iatsuk/nasa-duo-clipper-to-nmea2k/docs/power.ru.md

# Потребление: расчёт, не измерение

**Полностью автономное устройство пока не спроектировано: его потребление
неизвестно.** Ниже оценка LCD-прототипа с DevKitC, буфером и MIKROE-2627.
Потребление MFD и других приборов NMEA сюда не входит.

## Принятые величины

| Узел | Рабочая оценка | Статус |
|---|---:|---|
| ESP32 DevKitC, без радио | 50–100 мА на входе 5 В | Инженерный запас, зависит от платы, USB-UART, LED и CPU |
| Изолированный CAN-модуль | 30–90 мА от 5 В в среднем | Зависит от нагрузки шины; это не гарантированный максимум |
| Буфер и вспомогательные цепи | Эквивалент 5 мА от 5 В | Расчётный запас; потребление 3,3 В уже приведено к входу 5 В |
| КПД DC/DC | 85% | Допущение в рабочей точке, проверить измерением |
| Падение на входном диоде | Около 0,35 В | При малом токе, зависит от детали и температуры |
| Сохранённый NASA | 10–100 мА от 12 В | Широкий оценочный диапазон, **не паспорт Duet** |

Паспортные токи одного ESP32 не равны току DevKitC. Ток ADM3053 зависит от
состояния CAN; пиковый ток выше среднего. Питание 5 В выбрано с запасом до 1 А.
Основные источники: [ESP32](https://documentation.espressif.com/esp32_datasheet_en.pdf),
[ADM3053](https://www.analog.com/media/en/technical-documentation/data-sheets/ADM3053.pdf),
[DC/DC](https://www.pololu.com/product/2831).

## Формула

```text
I_5V = I_ESP32 + I_CAN + I_aux
I_bridge_12V = 5 × I_5V / (efficiency × (12 - V_diode))
I_total_12V = I_bridge_12V + I_NASA_12V
P_total = 12 × I_total_12V
Ah_per_day = 24 × I_total_12V
Wh_per_day = 24 × P_total
```

Диапазон дополнительного адаптера: примерно **0,52–1,18 Вт**, или
**43–98 мА от 12 В**. Вместе с сохранённым NASA получается примерно
**0,64–2,38 Вт**, **53–198 мА от 12 В**, **1,27–4,76 А·ч в сутки**.
Практически удобно округлить предварительный бюджет всей системы до **0,7–2,4 Вт**.
Это расчётный диапазон, не гарантированные минимум/максимум.

Центральный пример: ESP32 70 мА + CAN 45 мА + 5 мА вспомогательных = 120 мА
на 5 В. С учётом преобразования и диода адаптер берёт около 61 мА на 12 В.
Если конкретный NASA берёт 20 мА, сумма около **81 мА, 0,97 Вт, 1,93 А·ч/сутки**.
При 14 В ток будет другим; сравнивать полезнее ватт-часы.

Выполнить расчёт с другими допущениями:

```sh
python3 tools/power_budget.py
python3 tools/power_budget.py --voltage 13.8 --nasa-ma 30 --esp-ma 80
```

## Как получить настоящее число

1. Измерить отдельно ток штатного NASA при подсветке выключенной и включённой.
2. Измерить адаптер на его входе 12 В, без USB-питания, с подключённой CAN-сетью
   и реальным цифровым потоком. Измерение только по USB пропустит потери DC/DC.
3. Для амперметра разорвать **плюсовой провод после предохранителя** и включить
   прибор последовательно. Нельзя ставить амперметр поперёк аккумулятора.
   Если нет опыта, удобнее готовый DC-ваттметр или лабораторный источник с индикацией.
4. Записать напряжение, средний ток за 10 минут, максимум при старте, температуру
   корпуса после часа. Повторить при активной сети и включённом двигателе.
5. Измерить весь комплект на общем входе и сверить с суммой отдельных измерений.

В `docs/validation.ru.md` есть таблица для результатов. До её заполнения цифры
выше остаются оценкой. LEN=0 касается только питания от NET-S, а не аккумулятора.

Снижать потребление можно уменьшением частоты CPU после проверки захвата SPI,
заменой DevKitC на собственный модуль и выбором более экономичной изоляции.
Deep sleep не применим: пропуская LCD-поток и CAN, устройство теряет своё назначение.
