iatsuk/nasa-duo-clipper-to-nmea2k/docs/standalone.ru.md

# Полностью новая плата с прямыми входами датчиков

Это исходная цель проекта. Текущий LCD-прототип — вспомогательный вариант,
а не выполнение этой цели. Здесь нет готовых Gerber, аналогового приёмника
или прошивки возбуждения датчика: их нельзя обоснованно подобрать без измерений.

## Что уже известно

NASA продаёт запасной глубинный преобразователь **150 кГц**. Это пьезоэлемент
с коаксиальным кабелем, не NMEA-источник. Номинальную частоту конкретного датчика
нужно сопоставить с маркировкой. Инструкция Duet описывает регулировку усиления
приёмника и эхо-посылки. [NASA, документация и каталог](sources.md).

Для глубины понадобится передатчик, согласование с пьезоэлементом, развязка
передачи/приёма, защита чувствительного приёмника, полосовой усилитель,
детектор/АЦП и обработка нескольких отражений. Формула `d = c × t / 2` —
лишь последний шаг. При c≈1500 м/с глубине 100 м соответствует около 133 мс
двойного хода; это задаёт окно ожидания и ограничивает частоту посылок.

Популярный PGA460 не является готовым выбором для 150 кГц: его штатные диапазоны
30–80 и 180–480 кГц не включают эту частоту. Это проверено по
[документации TI](https://www.ti.com/lit/ds/symlink/pga460-q1.pdf).
Модули HC-SR04/JSN-SR04T для воздуха не заменяют морской эхолот.

Лаг проще, но тип его выхода нельзя угадывать: нужен сигнал вашего датчика,
питание/подтяжка, полярность, число импульсов за оборот и калибровка. Отсутствие
импульсов само по себе не отличает неподвижную лодку, заблокированную крыльчатку
и оборванный провод. Ни LCD-прототип, ни простой счётчик не решают это различие.

## Первый пакет данных — без выпайки и измерений высокого напряжения

1. Чёткое фото лицевой стороны: точное название Duet/Dual/другой модели.
2. Фото задней стороны и обоих штекеров, маркировок датчиков, если доступны.
3. При полностью отключённом питании — фото обеих плат с двух сторон,
   читаемые обозначения микросхем и версия PCB; ничего не отсоединять силой.
4. Размеры плат, высота компонентов, расстояния крепёжных отверстий.
5. Модель будущего MFD и желаемый предельный размер коробки.

**Фото помогут определить архитектуру, но не заменят следующие измерения.**

## Что измеряет специалист по электронике

| Измерение | Для какого решения |
|---|---|
| Импеданс/ёмкость датчика вместе с кабелем, резонанс | Согласующая цепь и передатчик |
| Напряжение, длительность, частота и число циклов штатной посылки | Напряжение ключей и параметры возбуждения |
| Затухание после посылки, эхо на нескольких глубинах | Защита приёмника, blanking, усиление, фильтрация |
| Динамика/амплитуда выхода лага и число импульсов на оборот | Входной буфер, подтяжка и калибровка |
| Работа при 10–15 В, моторе, помпе и зарядке | Питание, фильтры и помехоустойчивость |

Нужны осциллограф и подходящий дифференциальный высоковольтный пробник,
ограниченный источник питания, логический анализатор для **цифровых** линий.
Обычный USB-анализатор нельзя подключать к разъёму эхолота. Земля обычного
осциллографа может быть соединена с защитным заземлением: схему измерения выбирает
специалист. У пользователя без опыта этот этап не является инструкцией для самостоятельной пайки.

## После измерений

1. Составить измеренные характеристики и требования, выбрать аналоговую часть.
2. Проверить передатчик и приёмник на отдельном стенде с ограничением энергии.
3. Написать драйвер выбранной аналоговой части и обработку эха; использовать уже
   подготовленный NMEA-выход после испытаний.
4. Сравнить показания с исходным NASA на мелкой/большой глубине, при движении,
   пропадании эха, пузырьках и нескольких отражениях. Сохранить сырые записи.
5. Выпустить KiCad-схему, пройти ERC, развести плату, пройти DRC и проверку
   цепей питания/изоляции; заказать первый экземпляр, а не серию.
6. По фактической плате выпустить корпус, проверить нагрев, конденсат и вводы.

Размер, конечная BOM и потребление полностью автономной версии до выбора
аналоговой части **не определены**. ESP32 может остаться цифровым контроллером;
если нужная оцифровка/таймеры этого потребуют, выбор MCU пересматривается.
