iatsuk/nasa-duo-clipper-to-nmea2k/docs/bom.ru.md

# Что купить для LCD-прототипа

**Сначала подтвердить модель/ревизию NASA фотографиями.** Список относится к
адаптеру с сохранением прибора. Не заказывать по нему плату автономного эхолота.

| Количество | Позиция | Требование / где искать |
|---:|---|---|
| 1 | ESP32-DevKitC V4 с ESP32-WROOM-32E, 4 МБ | ESP32 классический; USB; магазины Espressif/Mouser/DigiKey |
| 1 | [MIKROE-2627 CAN Isolator Click](https://www.mikroe.com/can-isolator-click) | ADM3053; схема v100; наличие проверить у дистрибьютора |
| 1 | [Pololu D24V10F5, #2831](https://www.pololu.com/product/2831) | Фиксированные 5 В, до 1 А; не внешне похожая версия 3,3 В |
| 1 | [SN74LVC125AD](https://www.ti.com/product/SN74LVC125A) | SOIC-14; буфер с 5-В-толерантными входами |
| 1 | Переходник SOIC14→DIP14 | Под корпус AD; можно заказать уже припаянный U1 |
| 3 | Резисторы 1 кОм, 1%, 0,125 Вт или больше | Последовательно DATA/WR/CS |
| 3 | Резисторы 1 МОм | Определённые уровни входов U1 |
| 2 | Резисторы 10 кОм | TXD pull-up и ARM pull-up |
| 2 | Конденсаторы 100 нФ, керамика | U1 и выход 5 В |
| 1 | Конденсатор 1 мкФ, ≥10 В | U1, линия 3,3 В |
| 1 | Конденсатор 100 мкФ, 50 В | Вход DC/DC |
| 1 | Конденсатор 100 мкФ, 10 В или выше | Выход DC/DC |
| 1 | SS34 + удобный переходник при необходимости | Диод Шоттки защиты полярности |
| 1 | SMBJ18A + переходник | Однонаправленный TVS |
| 1 | Держатель предохранителя + предохранитель 0,5 А | В линию 12 В рядом с отбором питания |
| 1 | Паяемая макетная плата примерно 70×50 мм | Для буфера/защиты; размеры предварительные |
| 1 | Разъём 2 контакта + джампер | ARM |
| 1 | DB9 female breakout с номерами контактов | К CAN-модулю; закрепление винтами |
| 1 | NMEA 2000 Micro-C drop-кабель с открытым концом | Выбрать ответную часть под T-коннектор |
| 1 | T-коннектор NMEA 2000 | Если свободного ответвления нет |
| По месту | Провод, фиксируемые клеммы, термоусадка, стойки M3, винты | Питание 0,5 мм², сигналы 0,14–0,25 мм² |
| По месту | PETG/ASA и кабельные вводы | После измерения собранного адаптера |

У производителя MIKROE на момент просмотра отмечалось отсутствие платы в наличии.
Не заменять её произвольным «CAN module»: совместимость выводов, питания и изоляции
может отличаться. Если точная плата недоступна, потребуется адаптация списка и схемы.
Все модули работают без покупки основной платы/программатора MikroE.

Ориентир бюджета, **не корзина с проверенными ценами**: 100–180 евро за адаптер,
провода и разъёмы без MFD, приборов и работы мастера. Самая дорогая позиция —
изолированный CAN и морские соединители. Список не обещает минимальную стоимость.

## Инструменты

USB-кабель с передачей данных, компьютер, мультиметр, регулируемый паяльник,
тонкий припой и флюс, увеличительное стекло, отвёртки. Для первого включения
полезен лабораторный БП 12 В с ограничением тока. Логический анализатор нужен
для подтверждения LCD-потока на конкретной плате; подключается после буфера.
USB-CAN, умеющий 250 кбит/с и extended CAN, полезен для проверки NA и PGN,
но не заменяет согласование уровней на входе NASA.

На этапе полностью нового эхолота добавятся измерительные приборы и аналоговые
компоненты; они пока не выбраны. См. [отдельный план](standalone.ru.md).
