iatsuk/nasa-duo-clipper-to-nmea2k/(commit log)

2026-09-08 Add experimental ESP32 Duet LCD bridge and Russian build documentation
    [adapter.scad]
2026-09-08 Record successful ESP32 CI build and strengthen expiration regression coverage
